softcomplex/Digirig-Mobile/electric/3d-models/PJ320D.STEP

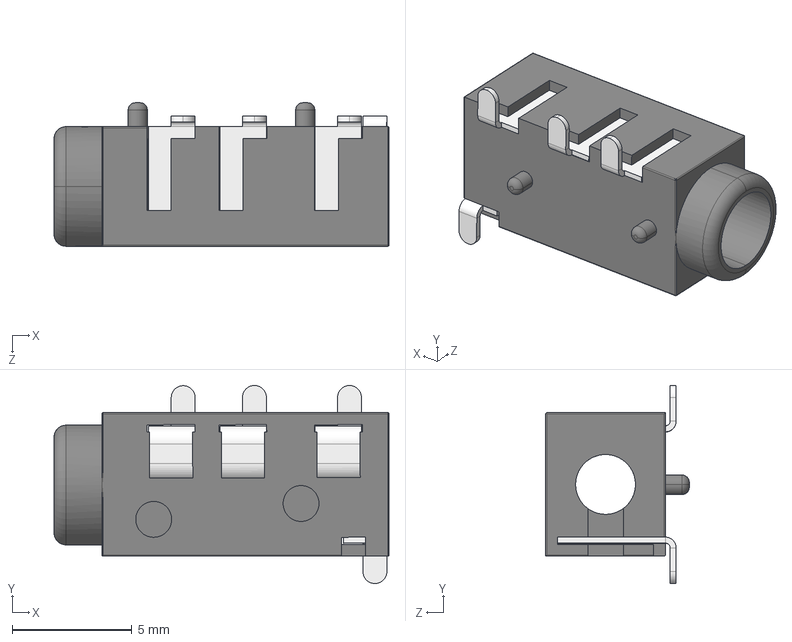
[picture p1: CAD file, 2021-12-10]
electric/3d-models/PJ320D.STEP
14.0 x 8.28 x 6.00 mm
PJ320A
PJ320D-Pin x 3
PJ320D-Pin-B
