softcomplex/Digirig-Mobile/electric/3d-models/PJ320A.STEP

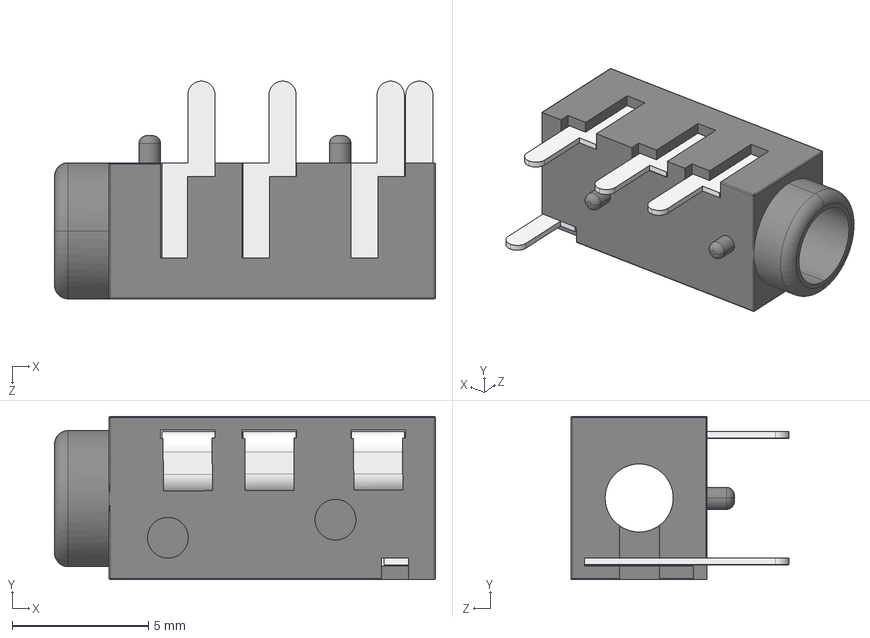
[picture p2: CAD file, 2021-12-10]
electric/3d-models/PJ320A.STEP
14.0 x 6.00 x 8.00 mm
PJ320A
PJ320A-Pin x 3
PJ320A-Pin-B
