softcomplex/Digirig-Mobile/electric/3d-models/QFN-12-1EP_3x3mm_P0.5mm_EP1.65x1.65mm.step

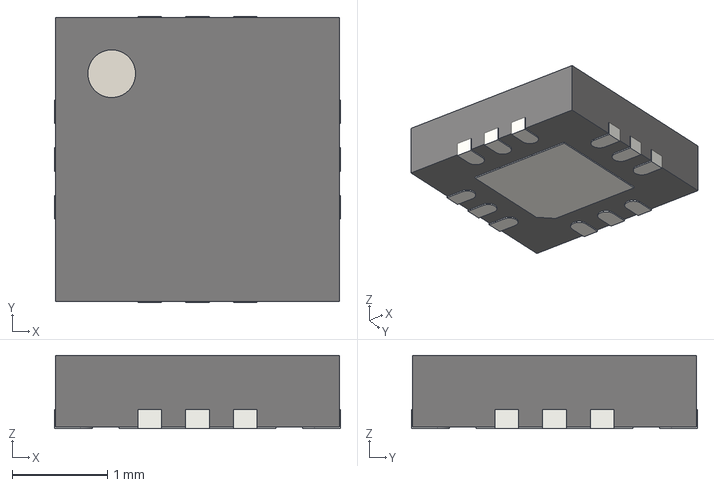
[picture p3: CAD file, 2021-12-10]
electric/3d-models/QFN-12-1EP_3x3mm_P0.5mm_EP1.65x1.65mm.step
3.00 x 3.00 x 0.77 mm
