softcomplex/Digirig-Mobile/(threads)

Thread 2 (2023-06-26):

Schematic Library is not included on this repository

antonjan, 2023-06-26:
Hi
It seems that then Schematic Library is not included on this repository.
Would it be possible to add the lib it is pointing to a digirig-shack-cash-lib that is not in repository or could you add the lib / syml files

Thanks
Anton

yeti7, 2023-07-01:
I found digirig-shack-cache.lib in the folder, but according to [this discussion](https://forum.kicad.info/t/do-we-still-need-these-files-cache-lib-fp-info-cache-on-kicad-v6/32803) *-cache.lib files should no longer be needed with most current Kicad version. I can email you a copy if you want it or include the file in the project if convinced that it is required.

chrisdebian, 2025-03-11:
Is this still an issue, or should it be closed?

Chris
