softcomplex/Digirig-Mobile/(commit log)

2021-01-17 Initial commit of revision 1 electric and resource files
    [digirig-mini.kicad_pcb, digirig-mini.sch, digirig.kicad_pcb, digirig.sch]
2021-01-23 revision 1.1
    hardware fix (pulldown resistor added)
    callsign update
    consistent version naming
    [digirig-mobile.kicad_pcb, digirig-mobile.sch, digirig-shack.kicad_pcb, digirig-shack.sch]
2021-01-25 Rev 1.1 Mods Continued
    Compressed mobile version to 23mm width
    Added pulldown resistors on secondary USB ports in shack version
    [digirig-mobile.csv, digirig-mobile.kicad_pcb, digirig-mobile.sch, digirig-shack.csv, digirig-shack.kicad_pcb, digirig-shack.sch]
2021-01-26 revision 1.3
    - uses two port embedded hub USB2412
    - reduced size to fit into 23x40mm for aluminum extrusion case
    [digirig-mobile.kicad_pcb, digirig-mobile.sch]
2021-01-27 components mods
    [digirig-mobile.csv, digirig-mobile.kicad_pcb, digirig-mobile.sch, digirig-shack.csv]
2021-01-27 component mods
    22uF -> 10uF
    [digirig-mobile.csv, digirig-mobile.sch, digirig-shack.csv]
2021-02-10 Revision 1.3
    Fixed USB2412 pins in schematic component
    Removed ESD (USB2412 supports internally)
    Removed some optional passives
    Added 3D model for 3.5mm jack
    Added panelization outline
    [digirig-mobile-panels.kicad_pcb, digirig-mobile.kicad_pcb, digirig-mobile.sch]
2021-03-14 Revision 1.3 updates
    [digirig-mobile-panelsx48.kicad_pcb, digirig-mobile.kicad_pcb, digirig-shack.kicad_pcb, digirig-shack.sch]
2021-04-05 rev 1.4
    - full re-layout
    - 50mm long PCB
    - USB type C connector
    - Serial data/control solder jumpers
    - TH header for Winlink and other uses
    [HRO TYPE-C-31-M-12.step, digirig-mobile.kicad_pcb, digirig-mobile.sch]
2021-04-15 rev 1.5
    - smaller footprint crystals
    - full re-layout... again
    - back to 40mm long PCB
    - non-inverting open collector drivers for RST/DTS lines
    [digirig-mobile.kicad_pcb, digirig-mobile.sch]
2021-04-18 revision 1.5 - tweaks
    - USB type C 3D model update
    - 3.5mm jack 3D model update
    - PCB cosmetic tweaks
    [HRO TYPE-C-31-M-12.step, HRO_TYPE-C-31-M-12.step, digirig-mobile.kicad_pcb]
2021-04-25 rev 1.5 panelized
    adjusted PCB origin point
    [digirig-mobile-panelsx48.kicad_pcb, digirig-mobile.kicad_pcb]
2021-05-06 Cosmetic Mods
    minor obsessing over schematic layout
    [digirig-mobile.sch]
2021-05-11 USB connector paste layer fix
    [digirig-mobile.kicad_pcb]
2021-05-12 Referenced moved to fab layer
    [digirig-mobile.kicad_pcb]
2021-06-05 Initial routing
    [PJ320D.STEP, digirig-mobile.kicad_pcb, digirig-mobile.sch]
2021-06-06 Revision 1.6 Prototype
    - TRRS connectors
    - Optional RS-232 level
    - Optional 3.3V output
    - Optional CI-V
    - PTT available by default (RST)
    - removed driving by DTR
    [QFN-12-1EP_3x3mm_P0.5mm_EP1.65x1.65mm.step, digirig-mobile.sch]
2021-06-16 Fixed power for ADM3101E
    [digirig-mobile.kicad_pcb, digirig-mobile.sch]
2021-07-28 Switched to through-hole TRS connectors
    [PJ320A.STEP, digirig-mobile.kicad_pcb, digirig-mobile.sch]
2021-07-30 Cosmetic mods
    [digirig-mobile.kicad_pcb, digirig-mobile.sch]
2021-09-17 Move track away from the solder jumper
    It was easy to accidentally cut the track while cutting between the pads of the solder jumper.
    [digirig-mobile.kicad_pcb]
2021-09-25 Smaller PCB size to better fit enclosure
    [digirig-mobile.kicad_pcb]
2021-12-10 Digirig 1.8
    - Moved attenuator on the other side of decoupling capacitor
    - Changed attenuator's ratio
    - Added low pass filter on audio input to suppress RF
    [digirig-mobile-panelsx48.kicad_pcb, digirig-mobile.kicad_pcb, digirig-mobile.sch]
2022-02-26 Digirig Mobile 1.9
    - additional solder jumper options to better accommodate CI-V
    - rearranged solder jumpers using custom footprint
    - RF shunting caps on audio
    [digirig-mobile-panelsx48.kicad_pcb, digirig-mobile.csv, digirig-mobile.kicad_pcb, digirig-mobile.kicad_sch, digirig-mobile.sch]
2022-04-16 Digirig Mobile 1.9 - final
    final cosmetic touches on digirig mobile 1.9
    folders structure reorganization
    logo resources mods
    [digirig-mobile.kicad_pcb, digirig-mobile.kicad_sch, digirig-shack.kicad_pcb, digirig-shack.sch]
2025-03-19 Digirig Mobile Rev 1.11
    Electrical for Digirig Mobile Rev 1.11
    - move from end of life CM108AH to current CM108B
    - move to a smaller enclosure
    - small adjustments to filtering
    - KiCad version update
    Resource file updates
    [HRO_TYPE-C-31-M-12.step, digirig-mobile.kicad_pcb, digirig-mobile.kicad_sch]
