softcomplex/Digirig-Mobile/(notices)

Notices in the files:
electric/3d-models/QFN-12-1EP_3x3mm_P0.5mm_EP1.65x1.65mm.step:
Copyright (C) 2017, kicad StepUp
This program is free software: you can redistribute it and/or modify
it under the terms of the GNU General Public License as published by
the Free Software Foundation, either version 3 of the License, or
any later version.
itself might be covered by the GNU General Public License.
electric/digirig-mobile/digirig-mobile.kicad_pcb:
GNU General Public License v3.0
